LostInCompilation/ObsidianHub/PCB/Plots/3D Render.png

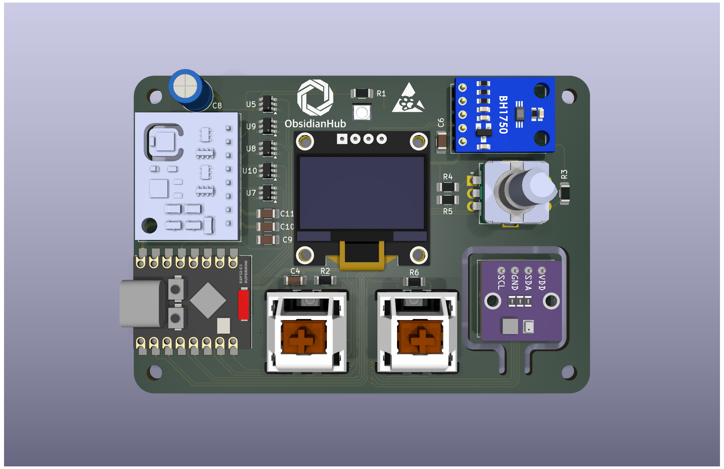
PCB/Plots/3D Render.png
