LostInCompilation/ObsidianHub/Case/3D Print/Keycaps/KeyCap Tight.step

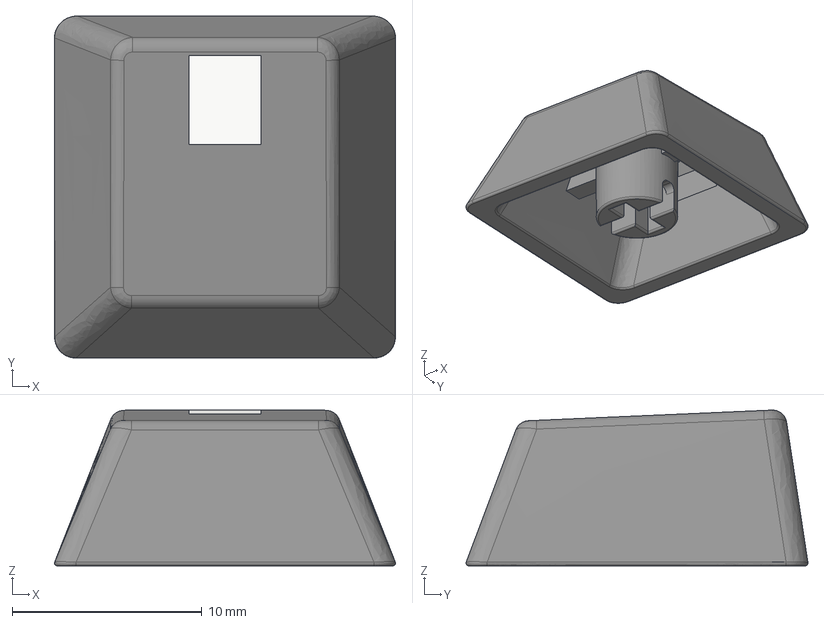
[picture p2: CAD file, 2025-12-12]
Case/3D Print/Keycaps/KeyCap Tight.step
18.0 x 18.0 x 8.21 mm
