LostInCompilation/ObsidianHub/Case/3D Print/TopCase.step

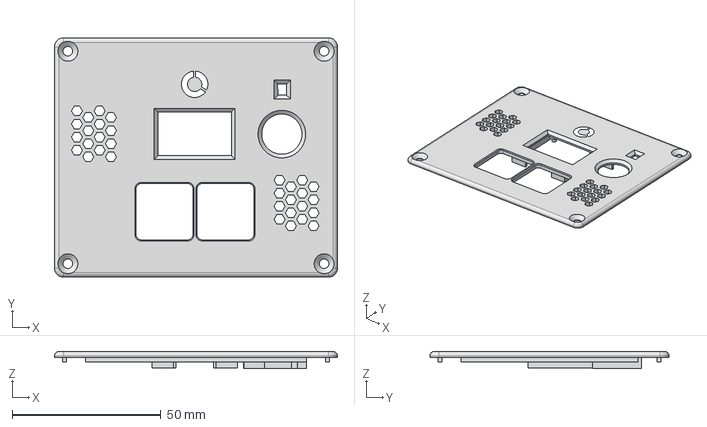
[picture p3: CAD file, 2025-12-12]
Case/3D Print/TopCase.step
95.1 x 80.4 x 5.75 mm
