LostInCompilation/ObsidianHub/Case/3D Print/BottomCase.3mf

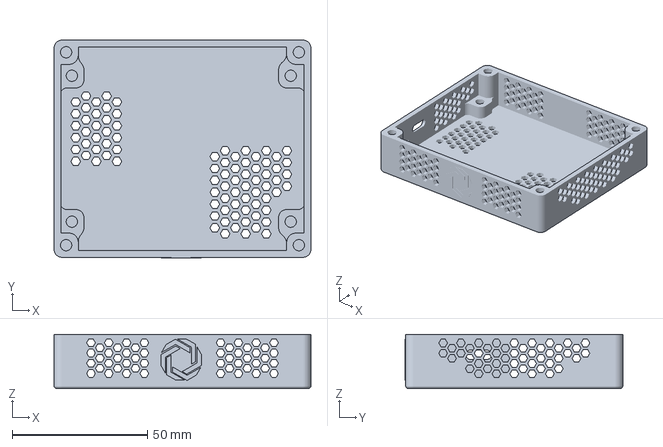
[picture p4: CAD file, 2025-12-12]
Case/3D Print/BottomCase.3mf
95.1 x 80.6 x 20.0 mm
