LostInCompilation/ObsidianHub/(list of files, cad)

Other CAD files:
Case/3D Print/BottomCase.stl
Case/3D Print/TopCase.3mf
