LostInCompilation/ObsidianHub/PCB/Plots/Schematic.pdf

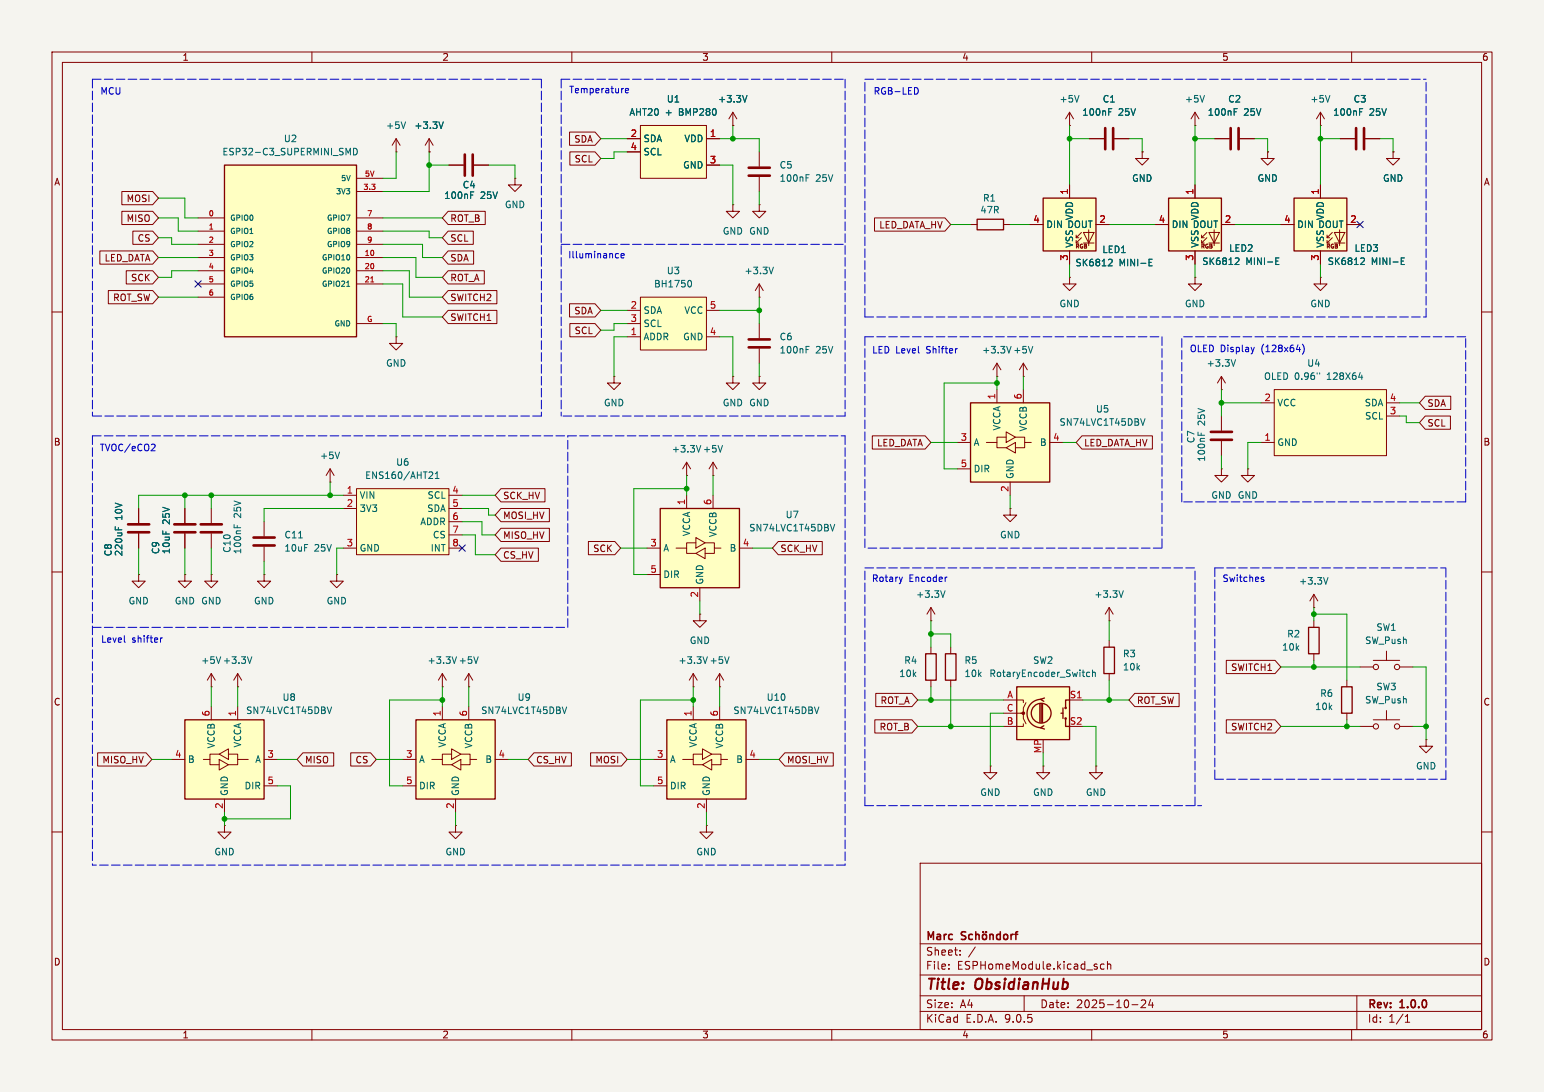
[picture p5: page 1]

LED Level Shifter Temperature
100nF 25V GND
