LostInCompilation/ObsidianHub/PCB/Plots/Board.pdf

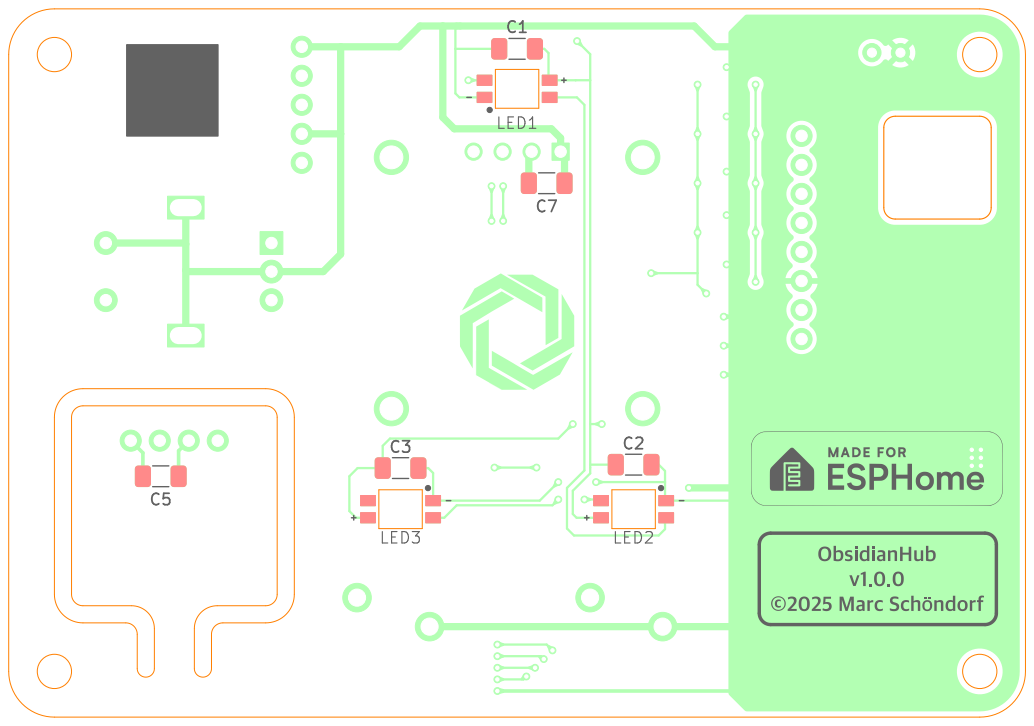
[picture p6: page 1]

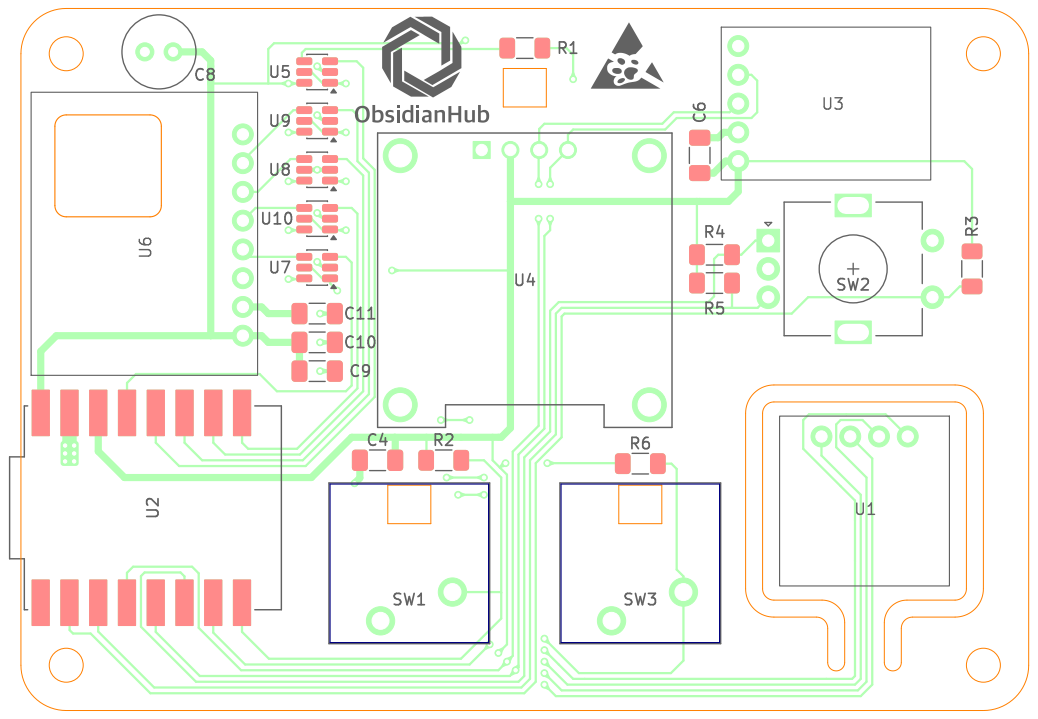
[picture p7: page 2]
