LostInCompilation/ObsidianHub/PCB/ObsidianHub.kicad_pcb

## KiCad design PCB/ObsidianHub.kicad_pcb (2025-12-12)

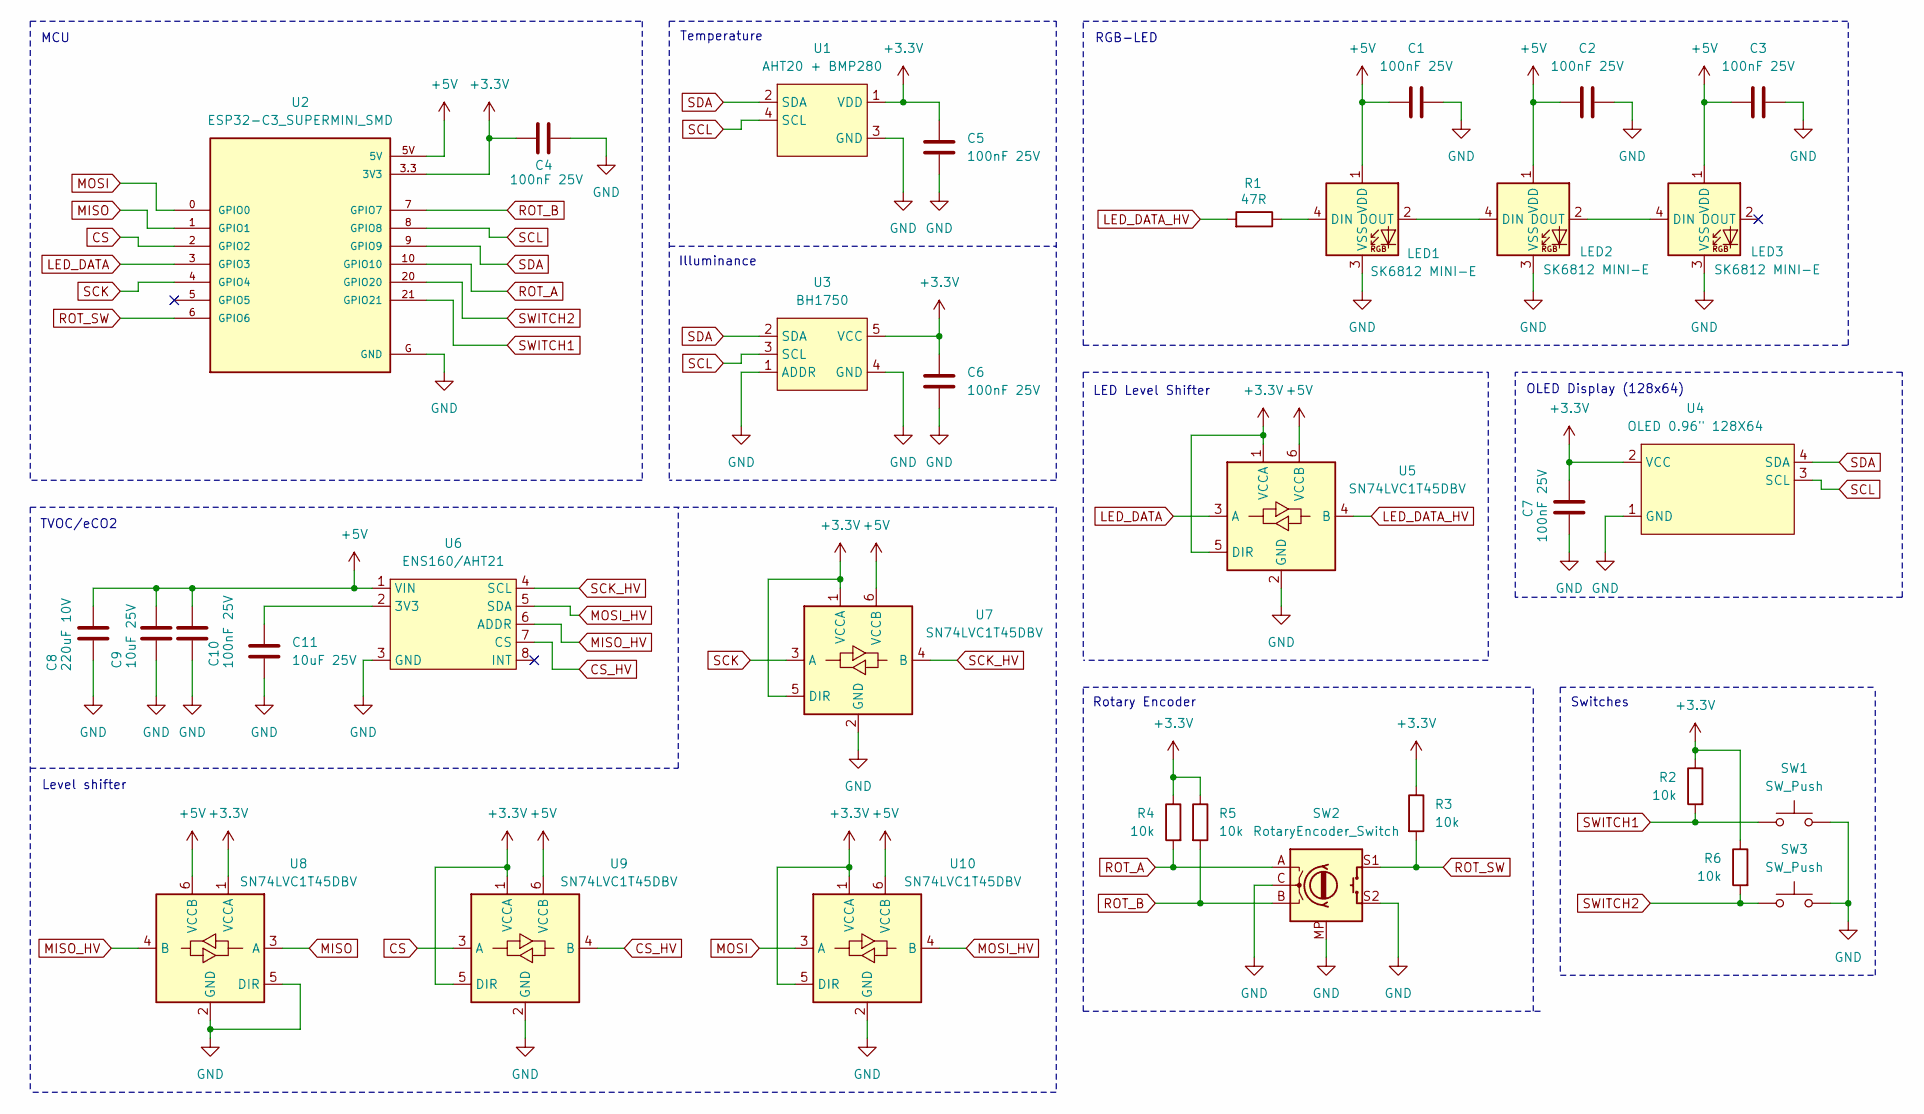
[picture p8: schematic ObsidianHub.kicad_sch]

Parts:
C1, C2, C3, C4, C5, C6, C7, C10: 100nF 25V; C_1206_3216Metric_Pad1.33x1.80mm_HandSolder
C8: 220uF 10V; C_Radial_D6.3mm_H7.0mm_P2.50mm
C9, C11: 10uF 25V; C_1206_3216Metric_Pad1.33x1.80mm_HandSolder
LED1, LED2, LED3: SK6812 MINI-E; LED SK6812-MINI-E Cutout
R1: 47R; R_1206_3216Metric_Pad1.30x1.75mm_HandSolder
R2, R3, R4, R5, R6: 10k; R_1206_3216Metric_Pad1.30x1.75mm_HandSolder
SW1, SW3: SW_Push; SW_Cherry_MX_PCB_1.00u
SW2: RotaryEncoder_Switch; RotaryEncoder_Alps_EC11E-Switch_Vertical_H20mm
U1: AHT20 + BMP280; MODULE_AHT20_BMP280
U2: ESP32-C3_SUPERMINI_SMD; MODULE_ESP32-C3_SUPERMINI
U3: BH1750
U4: OLED 0.96" 128X64; OLED 0.96 128x64
U5, U7, U8, U9, U10: SN74LVC1T45DBV; SOT-23-6
U6: ENS160/AHT21; ENS160_AHT21_Module

Connections:
+3.3V: C4.1, C5.1, C6.1, C7.1, R2.1, R3.1, R4.1, R5.1, R6.1, U1.1 (VDD), U2.3.3 (3V3), U3.5 (VCC), U4.2 (VCC), U5.1 (VCCA), U5.5 (DIR), U7.1 (VCCA), U7.5 (DIR), U8.1 (VCCA), U9.1 (VCCA), U9.5 (DIR), U10.1 (VCCA), U10.5 (DIR)
+5V: C1.1, C2.1, C3.1, C8.1, C9.1, C10.1, LED1.1 (VDD), LED2.1 (VDD), LED3.1 (VDD), U2.5V, U5.6 (VCCB), U6.1 (VIN), U7.6 (VCCB), U8.6 (VCCB), U9.6 (VCCB), U10.6 (VCCB)
CS: U2.2 (GPIO2), U9.3 (A)
CS_HV: U6.7 (CS), U9.4 (B)
GND: C1.2, C2.2, C3.2, C4.2, C5.2, C6.2, C7.2, C8.2, C9.2, C10.2, C11.2, LED1.3 (VSS), LED2.3 (VSS), LED3.3 (VSS), SW1.2, SW2.C, SW2.MP, SW2.S2, SW3.2, U1.3 (GND), U2.G (GND), U3.1 (ADDR), U3.4 (GND), U4.1 (GND), U5.2 (GND), U6.3 (GND), U7.2 (GND), U8.2 (GND), U8.5 (DIR), U9.2 (GND), U10.2 (GND)
LED_DATA: U2.3 (GPIO3), U5.3 (A)
LED_DATA_HV: R1.2, U5.4 (B)
MISO: U2.1 (GPIO1), U8.3 (A)
MISO_HV: U6.6 (ADDR), U8.4 (B)
MOSI: U2.0 (GPIO0), U10.3 (A)
MOSI_HV: U6.5 (SDA), U10.4 (B)
unnamed: LED1.4 (DIN), R1.1
unnamed: LED1.2 (DOUT), LED2.4 (DIN)
unnamed: LED2.2 (DOUT), LED3.4 (DIN)
unnamed: C11.1, U6.2 (3V3)
ROT_A: R4.2, SW2.A, U2.10 (GPIO10)
ROT_B: R5.2, SW2.B, U2.7 (GPIO7)
ROT_SW: R3.2, SW2.S1, U2.6 (GPIO6)
SCK: U2.4 (GPIO4), U7.3 (A)
SCK_HV: U6.4 (SCL), U7.4 (B)
SCL: U1.4 (SCL), U2.8 (GPIO8), U3.3 (SCL), U4.3 (SCL)
SDA: U1.2 (SDA), U2.9 (GPIO9), U3.2 (SDA), U4.4 (SDA)
SWITCH1: R2.2, SW1.1, U2.21 (GPIO21)
SWITCH2: R6.2, SW3.1, U2.20 (GPIO20)

Notes on the sheet:
RGB-LED
Temperature
Illuminance
TVOC/eCO2
Rotary Encoder
MCU
Switches
Level shifter
LED Level Shifter
OLED Display (128x64)

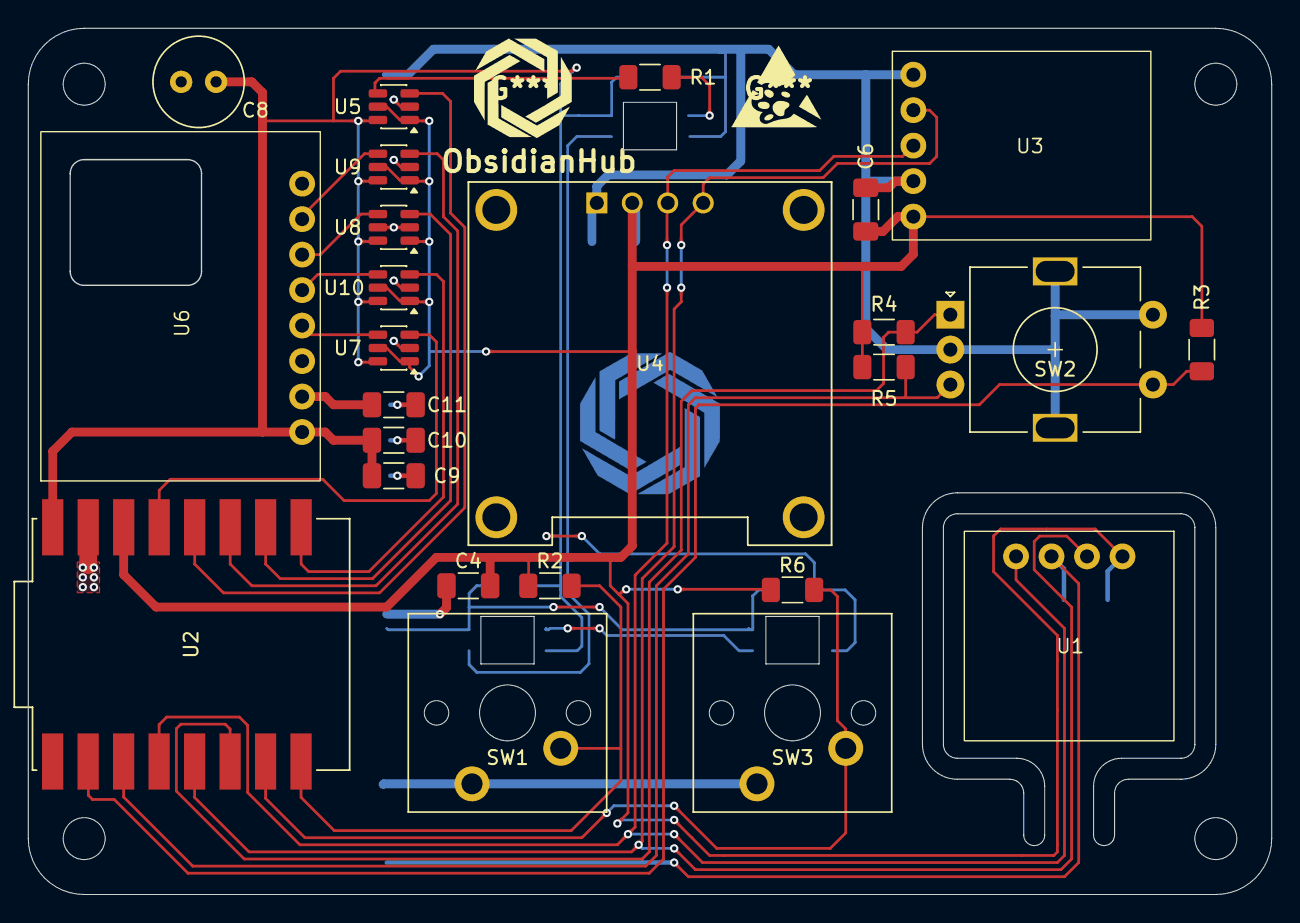
[picture p9: board ObsidianHub.kicad_pcb from above]

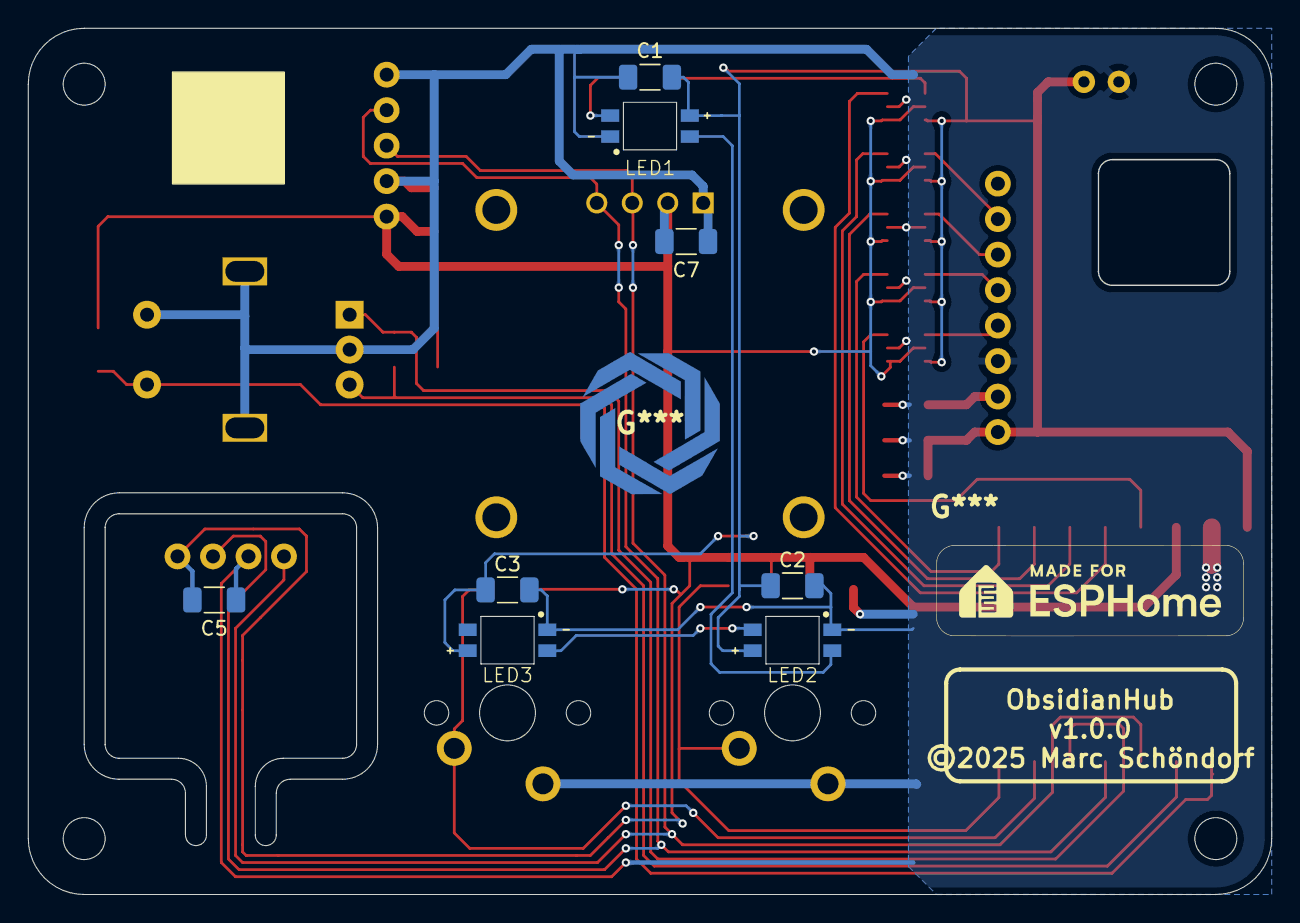
[picture p10: board ObsidianHub.kicad_pcb from below]

Board: 2 copper layers, 89.0 x 62.0 mm, 33 parts (8 on the bottom side), 24 nets.
