LostInCompilation/ObsidianHub/(commit log)

2025-12-12 Sdded status LED behaviour on wifi setup/disconnect
2025-12-12 Switch to online files
2025-12-13 Fix page switching logic
    [obsidianhub.yaml]
2025-12-14 LED work
2025-12-16 Added weather and location fetching (json parsing), added selection which components should go to sleep (display/LEDs), fixed bug where leds would fade out after display went to sleep, started weathe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
    [obsidianhub.yaml]
2025-12-16 Implemented later button on update available page
2025-12-17 Switched to fixed size integers
    [obsidianhub.yaml]
2025-12-17 Enable user specific updates, LED optimizations
2025-12-17 Reshow update available if user pressed later button
2025-12-17 Fixed display flicker on reboot, removed deprecated YAML syntax
    [obsidianhub.yaml]
2025-12-17 Show rebooting page after update finished
    [obsidianhub.yaml]
2025-12-21 Begin implementation of custom notifications with automatic scrolling, bug fixes
    [obsidianhub.yaml]
2025-12-22 Fixed formatting, notification page work and auto sleep and dimming bug fixes
    [obsidianhub.yaml]
2025-12-26 Added Fusion360 file for ObsidianHub (full CAD)
    [BottomCase.3mf, BottomCase.stl, KeyCap Tight.step, TopCase.3mf, TopCase.step]
2026-01-04 Reworked notification message word wrapping, scrolling and rendering. Switched to char arrays as buffers instead of STL
    [obsidianhub.yaml]
2026-01-08 Removed unneeded clamping
2026-01-09 Reworked Uptime Menu Entry Scrolling
    [obsidianhub.yaml]
2026-01-09 Added total device-on-time counter, small changes, CHANGELOG
