LostInCompilation/ObsidianHub/(notices)

Notices in the files:
PCB/ObsidianHub.kicad_pcb:
©2025 Marc Schöndorf
